UCSD-Quadcopter-Class/quad-hardware-group7/design_reviews/questions_about_our_board.txt

https://docs.google.com/document/d/1OBDGec99BBnkHRQAFpLlpPY4HDKG-HGubhnJSSOgmV4/edit
