UCSD-Quadcopter-Class/quad-hardware-group7/quadcopter.brd

## EAGLE design quadcopter.brd (2017-05-16)

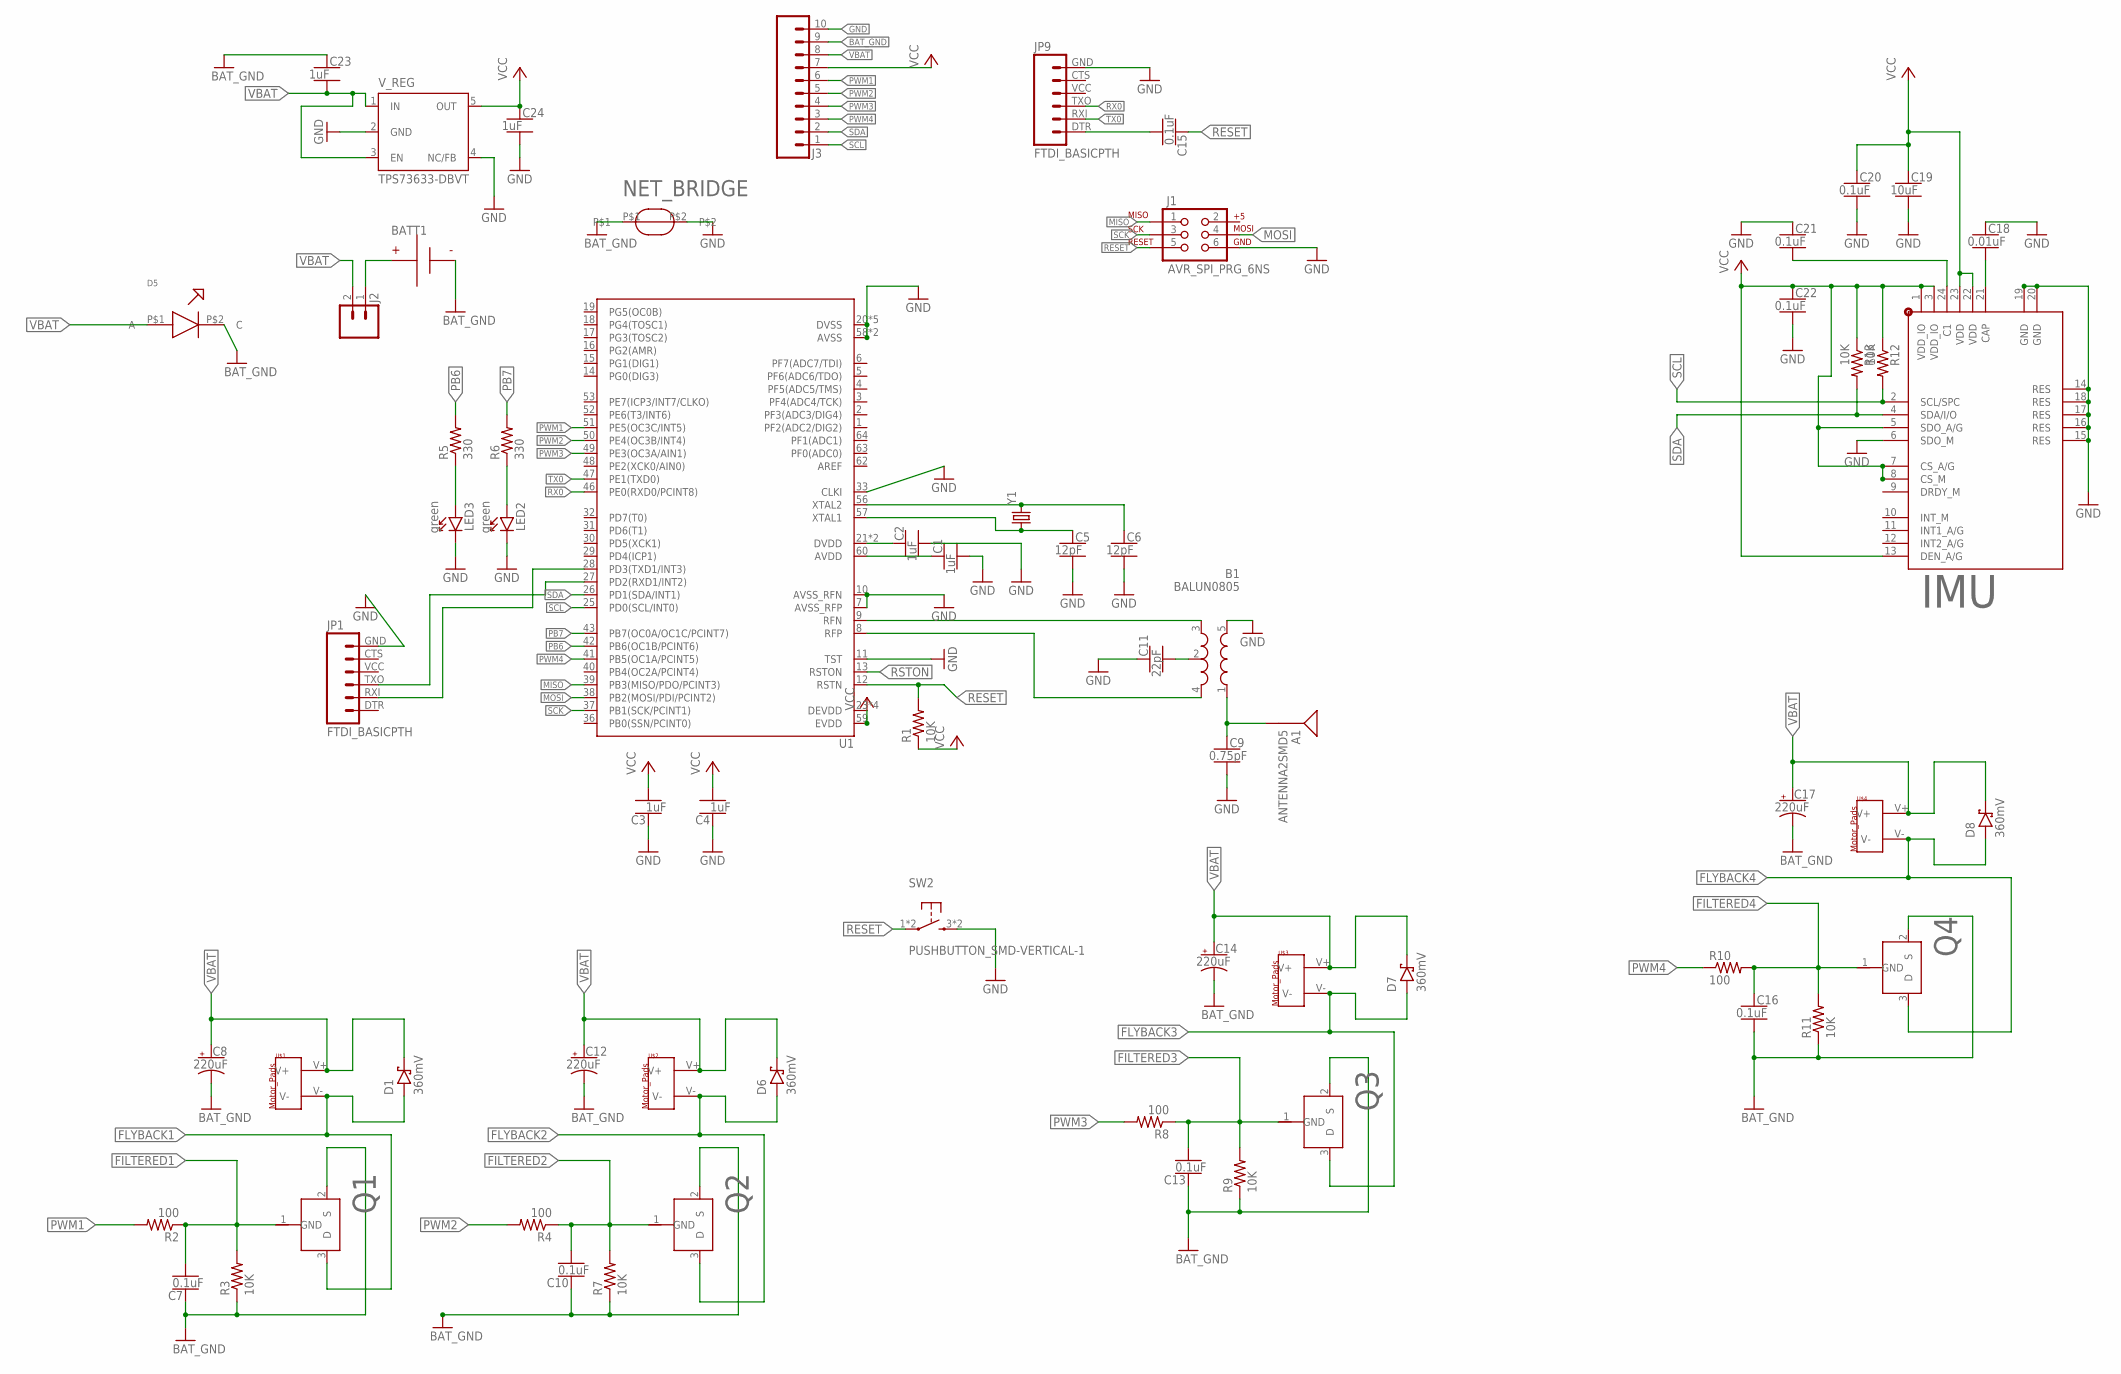
[picture p1: schematic quadcopter.sch]

Parts:
A1: ANTENNA2SMD5; ANTENNA-CHIP5
B1: BALUN0805; BALUN
BATT1: BATTERY-HUBSAN-W/HOLDER; BATTERY-W/HOLDER-380MAH-HUBSAN
C1, C2, C3, C4, C23, C24: 1uF; CAPC2012X140_HS
C5, C6: 12pF; CAPC2012X140_HS
C7, C10, C13, C15, C16, C20, C21, C22: 0.1uF; CAPC2012X140_HS
C8, C12, C14, C17: 220uF; CAPMP7343X310_HS
C9: 0.75pF; CAPC2012X140_HS
C11: 22pF; CAPC2012X140_HS
C18: 0.01uF; CAPC2012X140_HS
C19: 10uF; CAPC2012X140_HS
D1, D6, D7, D8: 360mV; SOD3716X135_HS
D5: BLUE_LED
IMU: 9-AXIS_IMU
J1: AVR_SPI_PRG_6NS; 2X3-NS
J2: MALE_HEADER_2POS-2X1-0.1IN; MALE_HEADER_2X1_0.1IN
J3: SIP-10_TH-254X10; HDRV10W63P254_10X1_2540X254H838_HS
JP1, JP9: FTDI_BASICPTH; FTDI_BASIC
LED2, LED3: green; LEDSC125X200X120-2_HS
NET_BRIDGE: NET_BRIDGE
Q1, Q2, Q3, Q4: N-CHANNEL_MOSFET
R1, R3, R7, R9, R11, R12, R13: 10K; RESC2012X60_HS
R2, R4, R8, R10: 100; RESC2012X60_HS
R5, R6: 330; RESC2012X60_HS
SW2: PUSHBUTTON_SMD-VERTICAL-1; TE_FSM8JSMA_HS
U1: ATMEGA128RFA1; QFN-64
U$1, U$2, U$3, U$4: MOTOR_PADS
V_REG: TPS73633-DBVT; SOT23-DBV
Y1: CRYSTAL5X3; CRYSTAL-SMD-5X3

Connections:
BAT_GND: BATT1.- (N), C7.1, C8.2 (-), C10.1, C12.2 (-), C13.1, C14.2 (-), C16.2, C17.2 (-), C23.1, D5.P$2 (C), J3.9, NET_BRIDGE.P$1, Q1.2 (S), Q2.2 (S), Q3.2 (S), Q4.2 (S), R3.1, R7.1, R9.1, R11.1
FILTERED1: C7.2, Q1.1 (GND), R2.1, R3.2
FILTERED2: C10.2, Q2.1 (GND), R4.1, R7.2
FILTERED3: C13.2, Q3.1 (GND), R8.1, R9.2
FILTERED4: C16.1, Q4.1 (GND), R10.2, R11.2
FLYBACK1: D1.A, Q1.3 (D), U$1.V-
FLYBACK2: D6.A, Q2.3 (D), U$2.V-
FLYBACK3: D7.A, Q3.3 (D), U$3.V-
FLYBACK4: D8.A, Q4.3 (D), U$4.V-
GND: B1.5 (GND), C1.2, C2.2, C3.1, C4.1, C5.2, C6.2, C9.2, C11.1, C18.1, C19.2, C20.2, C21.1, C22.2, C24.2, IMU.6 (SDO_M), IMU.14 (RES), IMU.15 (RES), IMU.16 (RES), IMU.17 (RES), IMU.18 (RES), IMU.19 (GND), IMU.20 (GND), J1.6, J3.10, JP1.GND (6), JP9.GND (6), LED2.C, LED3.C, NET_BRIDGE.P$2, SW2.3 (2), SW2.4 (2), U1.7 (AVSS_RFP), U1.10 (AVSS_RFN), U1.11 (TST), U1.20 (DVSS), U1.24 (DVSS), U1.33 (CLKI), U1.35 (DVSS), U1.45 (DVSS), U1.55 (DVSS), U1.58 (AVSS), U1.61 (AVSS), V_REG.2 (GND), V_REG.4 (NC/FB)
MISO: J1.1, U1.39 (PB3(MISO/PDO/PCINT3))
MOSI: J1.4, U1.38 (PB2(MOSI/PDI/PCINT2))
unnamed: C5.1, U1.57 (XTAL1), Y1.1
unnamed: C2.1, U1.21 (DVDD), U1.22 (DVDD)
unnamed: B1.3 (OUT2), U1.9 (RFN)
unnamed: C1.1, U1.60 (AVDD)
unnamed: B1.4 (OUT1), U1.8 (RFP)
unnamed: C6.1, U1.56 (XTAL2), Y1.3 (2)
unnamed: B1.2 (GND), C11.2
unnamed: A1.FEED, B1.1 (IN), C9.1
unnamed: JP1.TXO (3), U1.27 (PD2(RXD1/INT2))
unnamed: LED3.A, R5.1
unnamed: LED2.A, R6.1
unnamed: JP1.RXI (2), U1.28 (PD3(TXD1/INT3))
unnamed: C18.2, IMU.21 (CAP)
unnamed: C15.2, JP9.DTR (1)
unnamed: C21.2, IMU.24 (C1)
unnamed: BATT1.+, J2.1
PB6: R5.2, U1.42 (PB6(OC1B/PCINT6))
PB7: R6.2, U1.43 (PB7(OC0A/OC1C/PCINT7))
PWM1: J3.6, R2.2, U1.51 (PE5(OC3C/INT5))
PWM2: J3.5, R4.2, U1.50 (PE4(OC3B/INT4))
PWM3: J3.4, R8.2, U1.49 (PE3(OC3A/AIN1))
PWM4: J3.3, R10.1, U1.41 (PB5(OC1A/PCINT5))
RESET: C15.1, J1.5, R1.2, SW2.1, SW2.2 (1), U1.12 (RSTN)
RSTON: U1.13 (RSTON)
RX0: JP9.TXO (3), U1.46 (PE0(RXD0/PCINT8))
SCK: J1.3, U1.37 (PB1(SCK/PCINT1))
SCL: IMU.2 (SCL/SPC), J3.1, R12.2, U1.25 (PD0(SCL/INT0))
SDA: IMU.4 (SDA/I/O), J3.2, R13.2, U1.26 (PD1(SDA/INT1))
TX0: JP9.RXI (2), U1.47 (PE1(TXD0))
VBAT: C8.1 (+), C12.1 (+), C14.1 (+), C17.1 (+), C23.2, D1.C, D5.P$1 (A), D6.C, D7.C, D8.C, J2.2, J3.8, U$1.V+, U$2.V+, U$3.V+, U$4.V+, V_REG.1 (IN), V_REG.3 (EN)
VCC: C3.2, C4.2, C19.1, C20.1, C22.1, C24.1, IMU.1 (VDD_IO), IMU.3 (VDD_IO), IMU.5 (SDO_A/G), IMU.7 (CS_A/G), IMU.8 (CS_M), IMU.13 (DEN_A/G), IMU.22 (VDD), IMU.23 (VDD), J3.7, R1.1, R12.1, R13.1, U1.23 (DEVDD), U1.34 (DEVDD), U1.44 (DEVDD), U1.54 (DEVDD), U1.59 (EVDD), V_REG.5 (OUT)

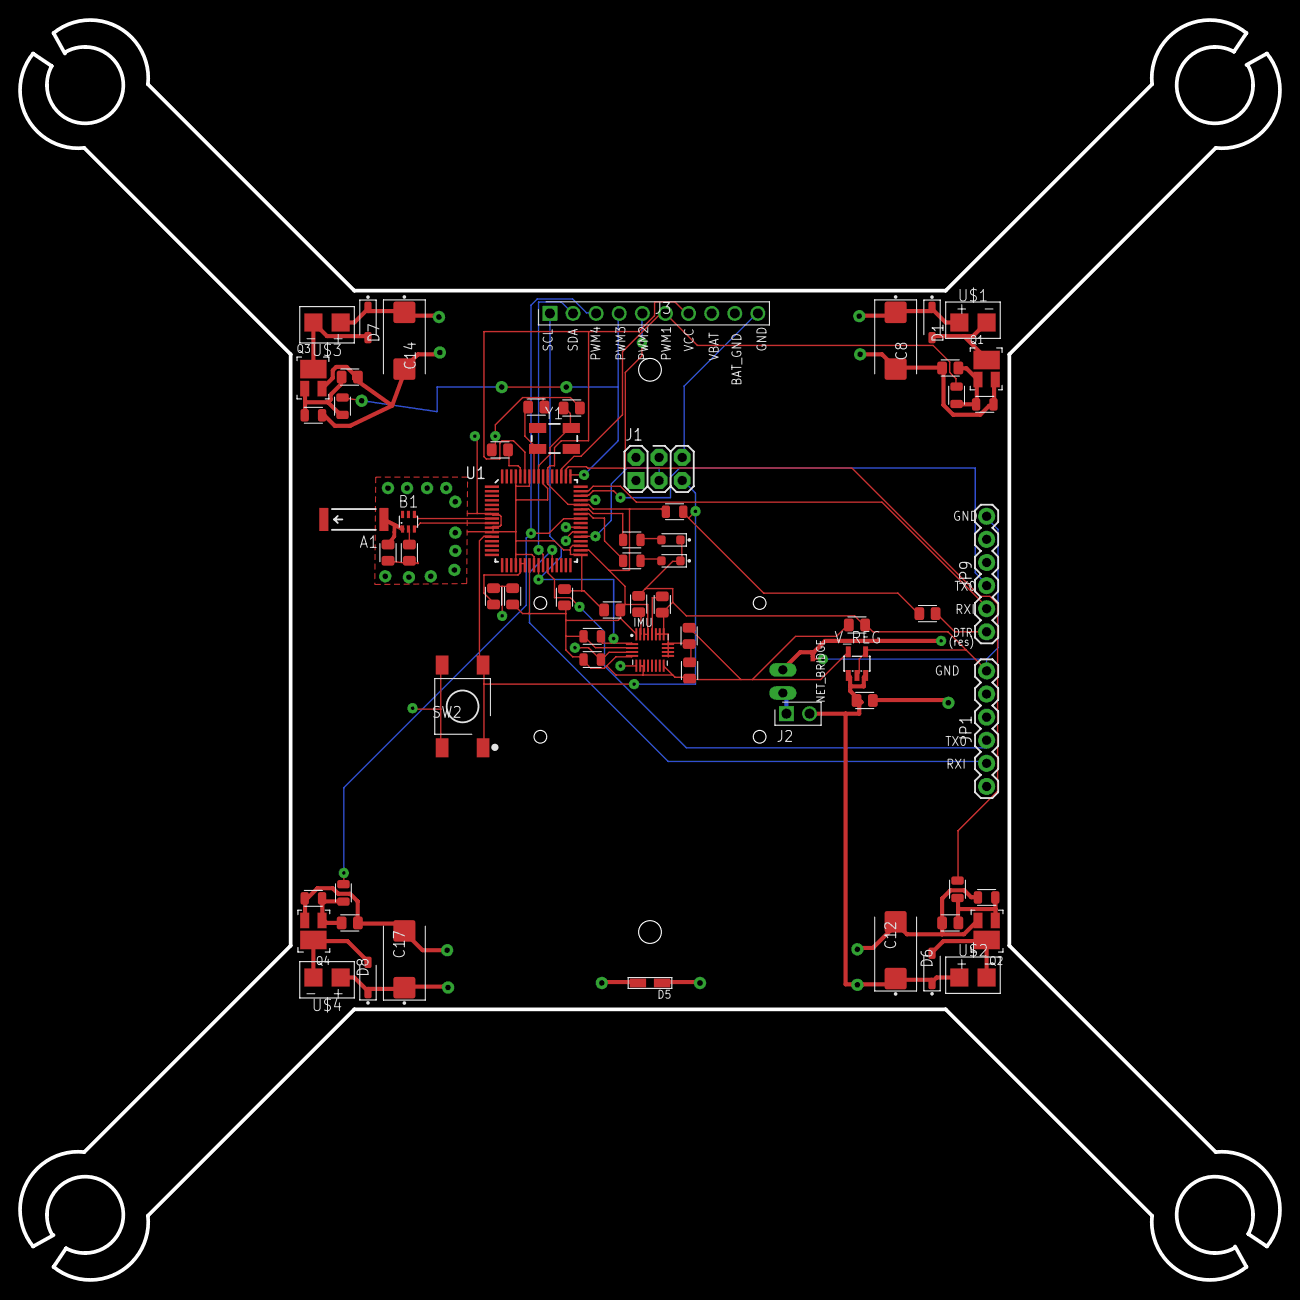
[picture p2: board quadcopter.brd from above]

Board: 4 copper layers, 138.5 x 138.5 mm, 66 parts (1 on the bottom side), 42 nets.
