UCSD-Quadcopter-Class/quad-hardware-group7/ATmega128RFA1-DevBoard.brd

## EAGLE design ATmega128RFA1-DevBoard.brd (2017-04-18)

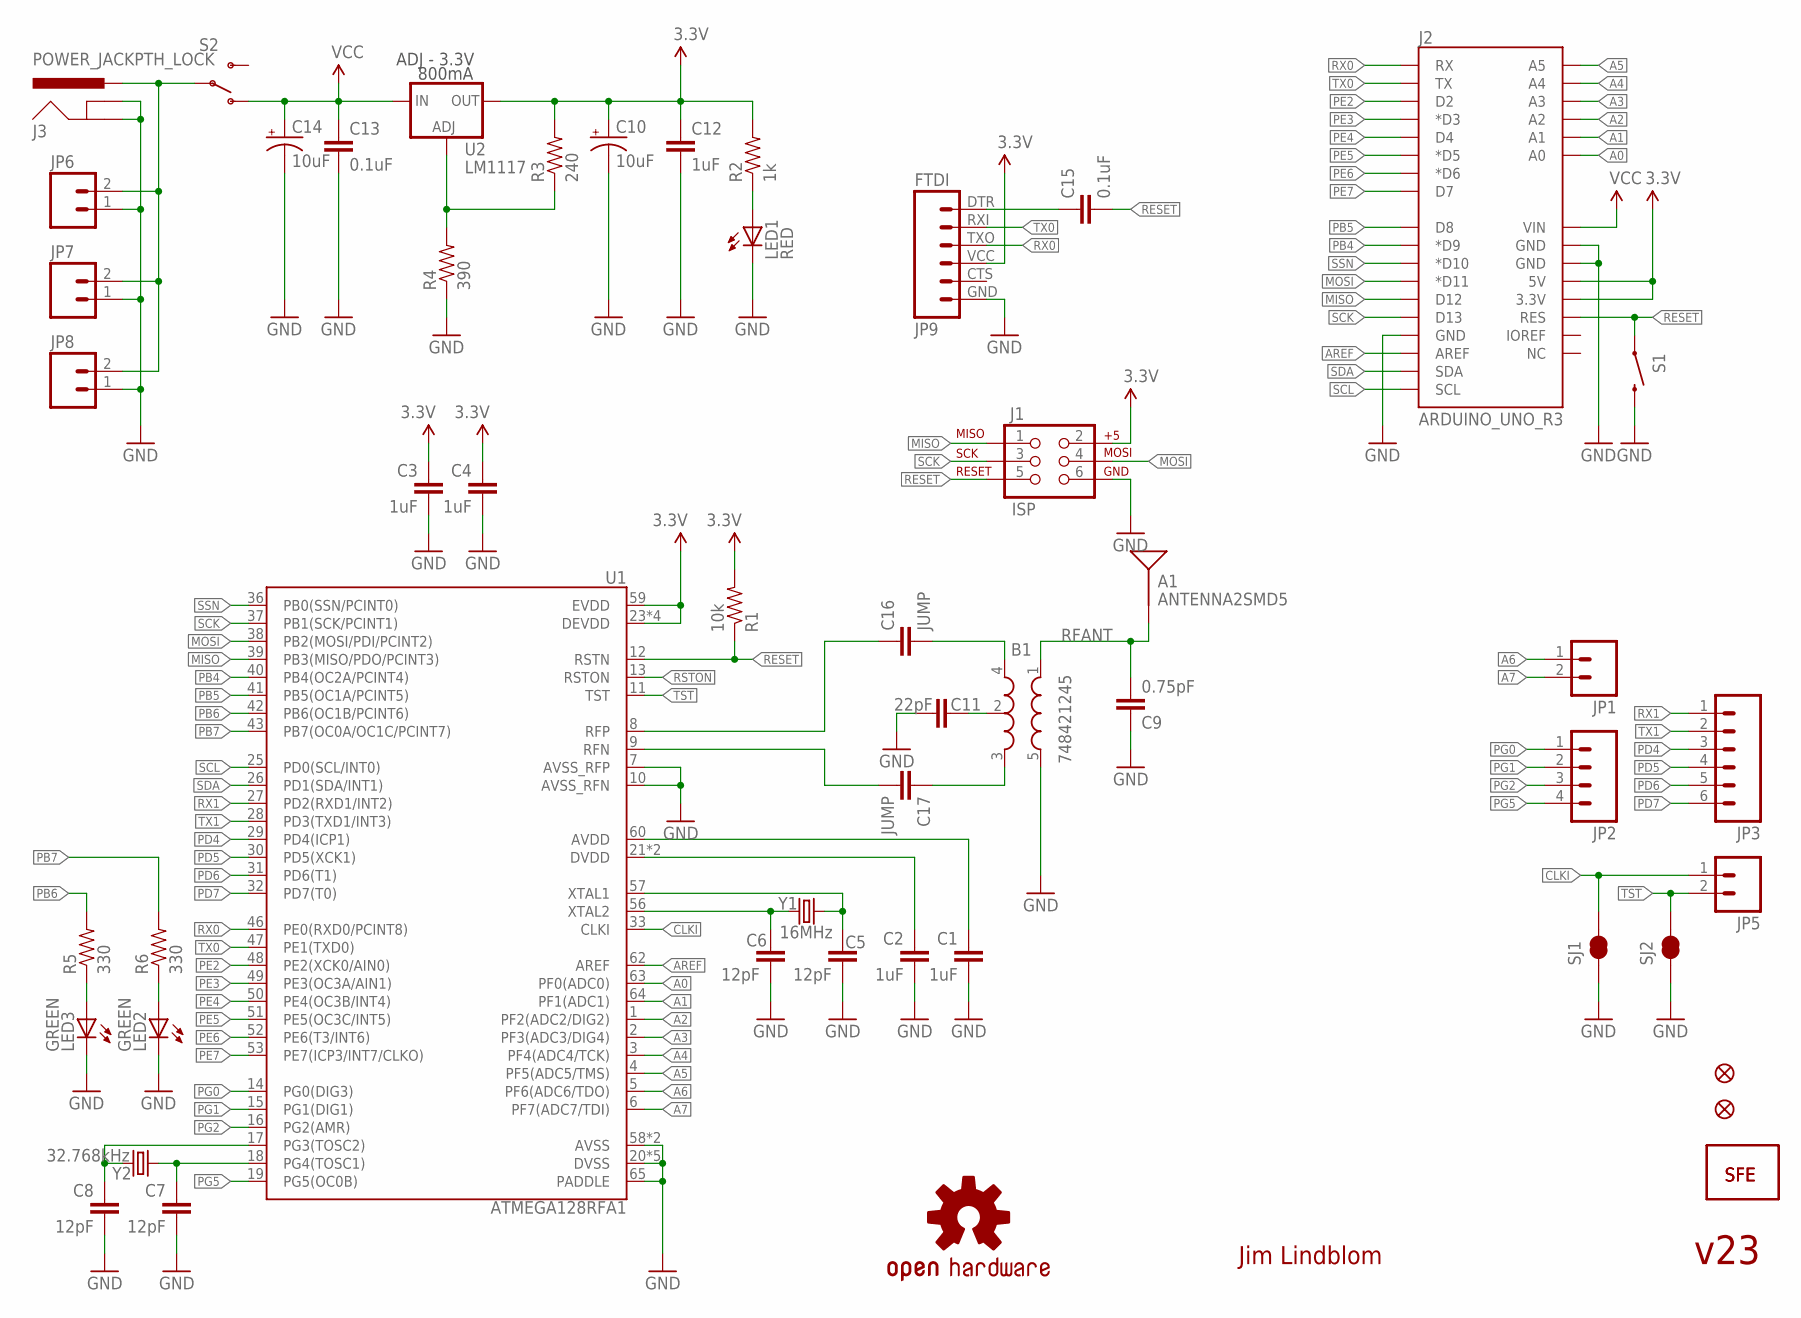
[picture p3: schematic ATmega128RFA1-DevBoard.sch]

Parts:
A1: ANTENNA2SMD5; ANTENNA-CHIP5
B1: 748421245; BALUN
C1, C2, C3, C4, C12: 1uF; 0402-CAP
C5, C6, C7, C8: 12pF; 0402-CAP
C9: 0.75pF; 0402-CAP
C10, C14: 10uF; EIA3216
C11: 22pF; 0402-CAP
C13, C15: 0.1uF; 0402-CAP
C16, C17: JUMP; 0402-CAP
FID1, FID2: FIDUCIALUFIDUCIAL; MICRO-FIDUCIAL
J1: ISP; 2X3-NS
J2: ARDUINO_UNO_R3
J3: POWER_JACKPTH_LOCK; POWER_JACK_PTH_LOCK
JP1, JP5, JP7: M021X02_NO_SILK; 1X02_NO_SILK
JP2: M041X04_NO_SILK; 1X04_NO_SILK
JP3: M06SIP-NS; 1X06_NS
JP4, JP10: LOGO-SFENEW; SFE-NEW-WEBLOGO
JP6: M02JST-PTH-2; JST-2-PTH
JP8: M023.5MM-NO_SILK; SCREWTERMINAL-3.5MM-2-NS
JP9: FTDI; FTDI_BASIC
LED1: RED; LED-0603
LED2, LED3: GREEN; LED-0603
R1: 10k; 0402-RES
R2: 1k; 0402-RES
R3: 240; 0402-RES
R4: 390; 0402-RES
R5, R6: 330; 0402-RES
S1: SWITCH-MOMENTARY-2SMD; TACTILE_SWITCH_SMD
S2: SWITCH-SPST-SMD-A
SJ1, SJ2: SOLDERJUMPERTRACE; SJ_2S-TRACE
U1: ATMEGA128RFA1; QFN-64
U2: LM1117; SOT223
U$1: OSHW-LOGOS; OSHW-LOGO-S
Y1: 16MHz; CRYSTAL-SMD-5X3
Y2: 32.768kHz; CRYSTAL-32KHZ-SMD

Connections:
3.3V: C3.1, C4.1, C10.A (+), C12.1, J1.2, J2.3.3V, J2.5V, JP9.VCC (4), R1.2, R2.2, R3.2, U1.23 (DEVDD), U1.34 (DEVDD), U1.44 (DEVDD), U1.54 (DEVDD), U1.59 (EVDD), U2.2 (OUT)
A0: J2.A0, U1.63 (PF0(ADC0))
A1: J2.A1, U1.64 (PF1(ADC1))
A2: J2.A2, U1.1 (PF2(ADC2/DIG2))
A3: J2.A3, U1.2 (PF3(ADC3/DIG4))
A4: J2.A4, U1.3 (PF4(ADC4/TCK))
A5: J2.A5, U1.4 (PF5(ADC5/TMS))
A6: JP1.1, U1.5 (PF6(ADC6/TDO))
A7: JP1.2, U1.6 (PF7(ADC7/TDI))
AREF: J2.AREF, U1.62 (AREF)
AVDD: C1.1, U1.60 (AVDD)
CLKI: JP5.1, SJ1.2, U1.33 (CLKI)
DTR: C15.1, JP9.DTR (1)
DVDD: C2.1, U1.21 (DVDD), U1.22 (DVDD)
FB: R3.1, R4.2, U2.1 (ADJ)
GND: B1.5 (GND), C1.2, C2.2, C3.2, C4.2, C5.2, C6.2, C7.2, C8.2, C9.1, C10.C (-), C11.2, C12.2, C13.2, C14.C (-), J1.6, J2.GND@0 (GND), J2.GND@1 (GND), J2.GND@2 (GND), J3.GND, J3.GNDBREAK, JP6.1, JP7.1, JP8.1, JP9.GND (6), LED1.C, LED2.C, LED3.C, R4.1, S1.3 (2), SJ1.1, SJ2.1, U1.7 (AVSS_RFP), U1.10 (AVSS_RFN), U1.20 (DVSS), U1.24 (DVSS), U1.35 (DVSS), U1.45 (DVSS), U1.55 (DVSS), U1.58 (AVSS), U1.61 (AVSS), U1.65 (PADDLE)
MISO: J1.1, J2.D12, U1.39 (PB3(MISO/PDO/PCINT3))
MOSI: J1.4, J2.D11 (*D11), U1.38 (PB2(MOSI/PDI/PCINT2))
unnamed: LED1.A, R2.1
unnamed: C5.1, U1.57 (XTAL1), Y1.3 (2)
unnamed: C6.1, U1.56 (XTAL2), Y1.1
unnamed: C7.1, U1.18 (PG4(TOSC1)), Y2.X1 (1)
unnamed: C8.1, U1.17 (PG3(TOSC2)), Y2.X2 (2)
unnamed: B1.2 (GND), C11.1
unnamed: LED3.A, R5.1
unnamed: J3.PWR, JP6.2, JP7.2, JP8.2, S2.2
unnamed: B1.4 (OUT1), C16.2
unnamed: B1.3 (OUT2), C17.1
unnamed: LED2.A, R6.1
PB4: J2.D9 (*D9), U1.40 (PB4(OC2A/PCINT4))
PB5: J2.D8, U1.41 (PB5(OC1A/PCINT5))
PB6: R5.2, U1.42 (PB6(OC1B/PCINT6))
PB7: R6.2, U1.43 (PB7(OC0A/OC1C/PCINT7))
PD4: JP3.3, U1.29 (PD4(ICP1))
PD5: JP3.4, U1.30 (PD5(XCK1))
PD6: JP3.5, U1.31 (PD6(T1))
PD7: JP3.6, U1.32 (PD7(T0))
PE2: J2.D2, U1.48 (PE2(XCK0/AIN0))
PE3: J2.D3 (*D3), U1.49 (PE3(OC3A/AIN1))
PE4: J2.D4, U1.50 (PE4(OC3B/INT4))
PE5: J2.D5 (*D5), U1.51 (PE5(OC3C/INT5))
PE6: J2.D6 (*D6), U1.52 (PE6(T3/INT6))
PE7: J2.D7, U1.53 (PE7(ICP3/INT7/CLKO))
PG0: JP2.1, U1.14 (PG0(DIG3))
PG1: JP2.2, U1.15 (PG1(DIG1))
PG2: JP2.3, U1.16 (PG2(AMR))
PG5: JP2.4, U1.19 (PG5(OC0B))
RESET: C15.2, J1.5, J2.RES, R1.1, S1.1, U1.12 (RSTN)
RFANT: A1.FEED, B1.1 (IN), C9.2
RFN: C17.2, U1.9 (RFN)
RFP: C16.1, U1.8 (RFP)
RSTON: U1.13 (RSTON)
RX0: J2.RX, JP9.TXO (3), U1.46 (PE0(RXD0/PCINT8))
RX1: JP3.1, U1.27 (PD2(RXD1/INT2))
SCK: J1.3, J2.D13, U1.37 (PB1(SCK/PCINT1))
SCL: J2.SCL, U1.25 (PD0(SCL/INT0))
SDA: J2.SDA, U1.26 (PD1(SDA/INT1))
SSN: J2.D10 (*D10), U1.36 (PB0(SSN/PCINT0))
TST: JP5.2, SJ2.2, U1.11 (TST)
TX0: J2.TX, JP9.RXI (2), U1.47 (PE1(TXD0))
TX1: JP3.2, U1.28 (PD3(TXD1/INT3))
VCC: C13.1, C14.A (+), J2.VIN, S2.1 (O), U2.3 (IN)

Notes on the sheet:
Jim Lindblom
800mA
ADJ - 3.3V
v23

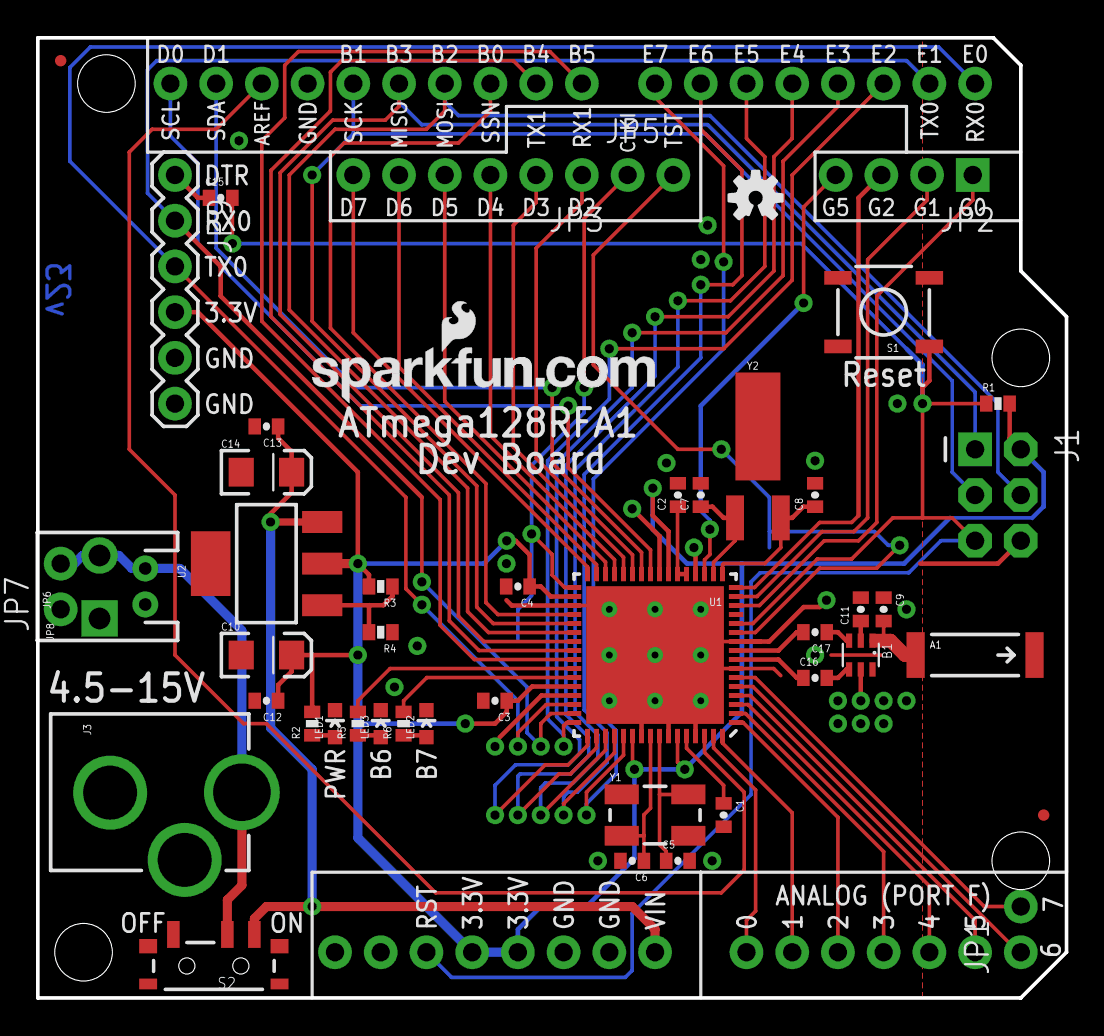
[picture p4: board ATmega128RFA1-DevBoard.brd from above]

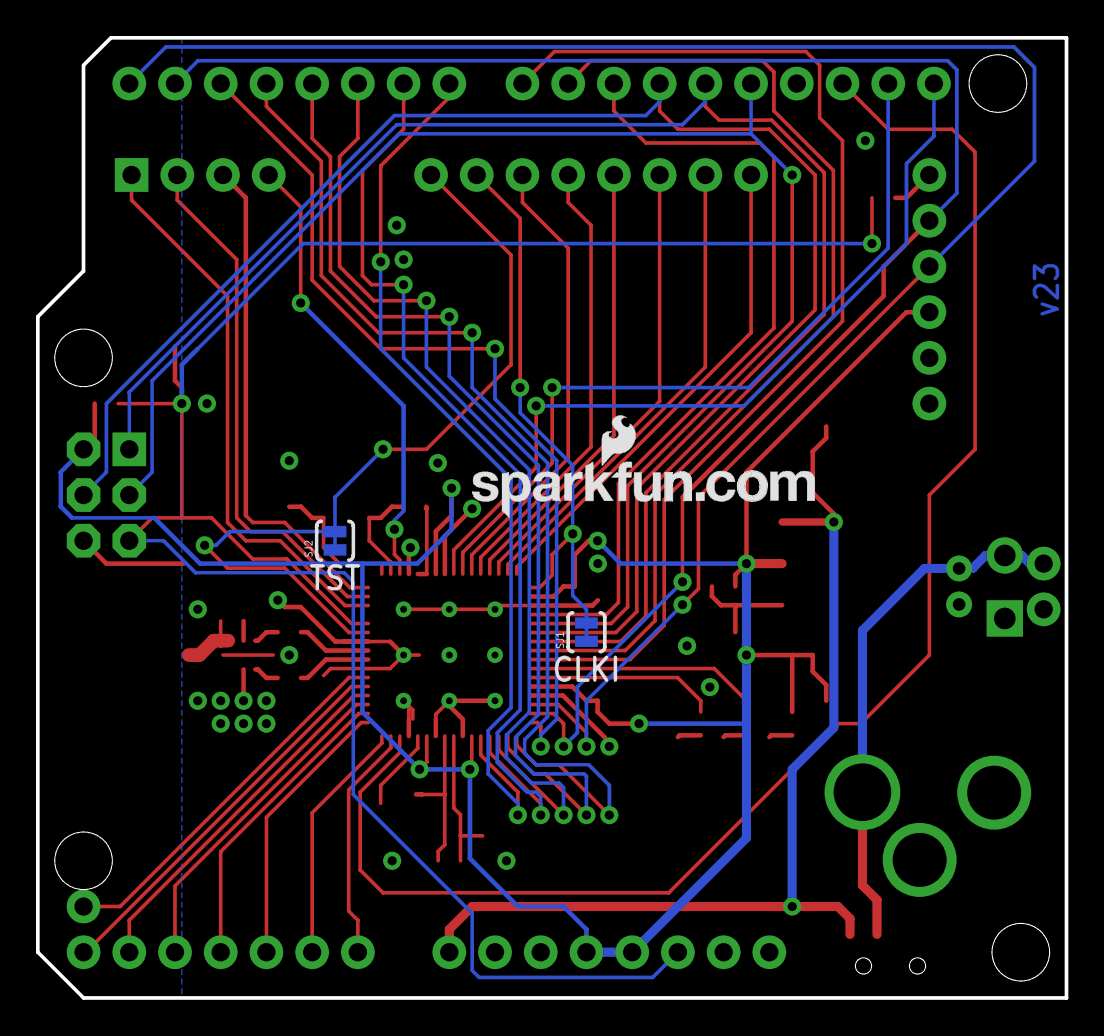
[picture p5: board ATmega128RFA1-DevBoard.brd from below]

Board: 2 copper layers, 57.1 x 53.3 mm, 52 parts (3 on the bottom side), 61 nets.
