UCSD-Quadcopter-Class/quad-hardware-group7/(commit log)

2017-04-18 Added redboard sch and board
    [ATmega128RFA1-DevBoard.brd, ATmega128RFA1-DevBoard.sch]
2017-04-18 most work done on quadcopter.sch
    [quadcopter.sch]
2017-04-18 Added breakout header and power-supply parts
    [quadcopter.sch]
2017-04-20 Hooked up power supply, fixed some connections on IMU
    [quadcopter.sch]
2017-04-20 fixed a few nets
    [quadcopter.sch]
2017-04-23 Added Blue LED
2017-04-23 Added LED to design
    [quadcopter.sch]
2017-04-23 Added frame and moved all parts in schematic to fit the frame
    [quadcopter.sch]
2017-04-23 fixed gnd->bat_gnd for all motor parts. also flipped source and drain
    [quadcopter.sch]
2017-04-25 Made all the review changes
    [quadcopter.sch]
2017-04-25 Enlarged mosfet pads per profs recommendation
2017-04-26 Fixed tStop for pads in the IMU
2017-04-27 instructior review of original schematic
2017-04-27 Made changes according to Profs feedback
    [quadcopter.sch]
2017-04-30 updated quadcopter.sch libraries
    [quadcopter.sch]
2017-04-30 created dimensions of board and added design rules
    [quadcopter.brd]
2017-05-01 Did board work, renamed flyback and filtered in schematic
    [quadcopter.brd, quadcopter.sch]
2017-05-01 board before auto-routing
    [quadcopter.brd]
2017-05-01 Routed and manually connected most wires. Waiting on piazza question before connecting the last few
    [quadcopter.brd]
2017-05-02 finished routing
    [quadcopter.brd, quadcopter.sch]
2017-05-04 Commiting before the autorouter ruins e verything
    [quadcopter.brd]
2017-05-04 Autorouting complete after review
    [quadcopter.brd]
2017-05-04 Added additional 2mm to arm lengths"
    [quadcopter.brd]
2017-05-05 Changed ground on LED to batgnd"
    [quadcopter.brd, quadcopter.sch]
2017-05-09 Board passes DFM
    [quadcopter.brd]
2017-05-09 Approved all DRC checks in board. renamed files to fit naming convention for lab8"
    [quadcopter.brd]
2017-05-10 Board design review 1
2017-05-11 Made most of swanson changes. Did not add reset button yet and did not autoroute and did not add in holes yet
    [quadcopter.brd, quadcopter.sch]
2017-05-12 added reset button and did autorouting
    [quadcopter.brd, quadcopter.sch]
2017-05-14 more schematic comments from swanson
2017-05-15 Made all changes specified in design review. Except LED
    [quadcopter.brd, quadcopter.sch]
2017-05-15 Changed the resistor and capacitor placements in the motor drivers
    [quadcopter.brd, quadcopter.sch]
2017-05-16 Oriented all GND and VCC symbols in the sch correctly
    [quadcopter.sch]
2017-05-16 Fix gnd/bat_gnd issue and re ran cam job
    [quadcopter.brd, quadcopter.sch]
